HALtheWise/eclectronics-micro-quad/microquad-v1/fab-help.pdf

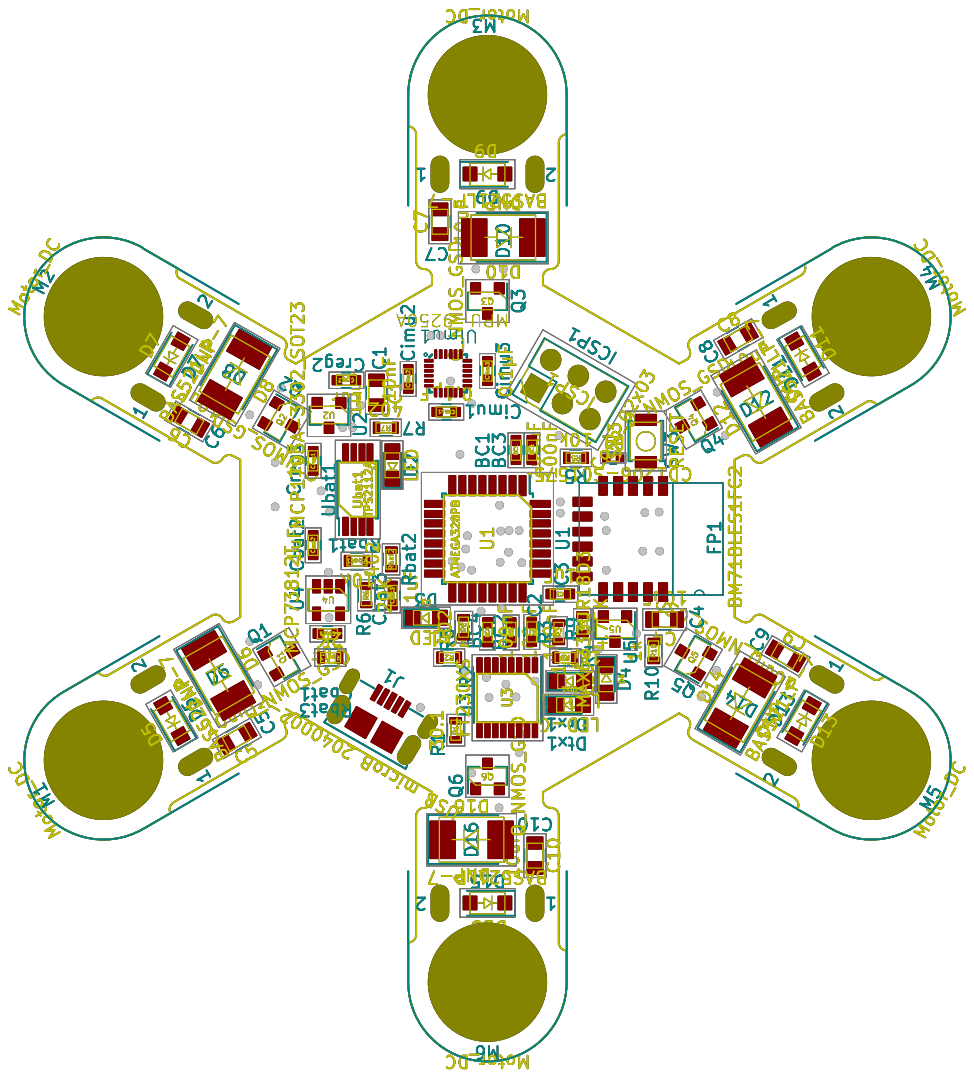
[picture p2: page 1]
