HALtheWise/eclectronics-micro-quad/microquad-v1/microquad-v1.kicad_pcb

## KiCad design microquad-v1/microquad-v1.kicad_pcb (2017-11-17)

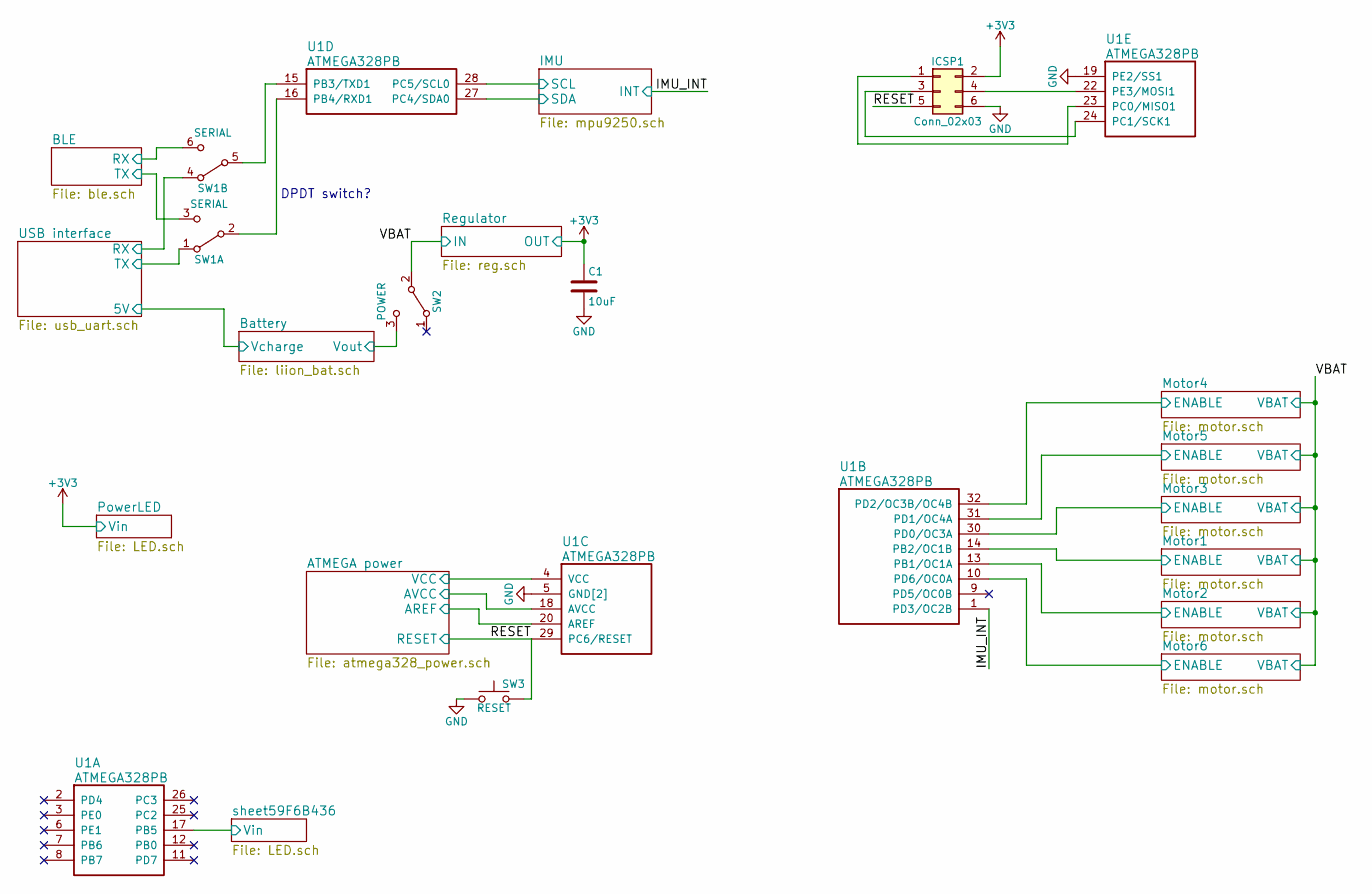
[picture p3: schematic microquad-v1.sch]

Parts:
C1: 10uF; C_0805
ICSP1: Conn_02x03; Pin_Header_Straight_2x03_Pitch2.54mm
SW1: SERIAL; quad_switch
SW2: POWER; quad_switch
SW3: RESET; SW_SPST_B3U-1000P
U1: ATMEGA328PB; TQFP-32_7x7mm_Pitch0.8mm

Connections:
+3V3: C1.1, ICSP1.2, U1.4 (VCC), U1.18 (AVCC), U1.20 (AREF); also elsewhere on the board
/BLE/RX: SW1.6 (C); also elsewhere on the board
/BLE/TX: SW1.3 (C); also elsewhere on the board
/Battery/Vout: SW2.3 (C); also elsewhere on the board
/IMU/SCL: U1.28 (PC5/SCL0); also elsewhere on the board
/IMU/SDA: U1.27 (PC4/SDA0); also elsewhere on the board
/IMU_INT: U1.1 (PD3/OC2B); also elsewhere on the board
/Motor1/ENABLE: U1.14 (PB2/OC1B); also elsewhere on the board
/Motor2/ENABLE: U1.13 (PB1/OC1A); also elsewhere on the board
/Motor3/ENABLE: U1.30 (PD0/OC3A); also elsewhere on the board
/Motor4/ENABLE: U1.32 (PD2/OC3B/OC4B); also elsewhere on the board
/Motor5/ENABLE: U1.31 (PD1/OC4A); also elsewhere on the board
/Motor6/ENABLE: U1.10 (PD6/OC0A); also elsewhere on the board
/RESET: ICSP1.5, SW3.2, U1.29 (PC6/RESET); also elsewhere on the board
/USB interface/RX: SW1.4 (A); also elsewhere on the board
/USB interface/TX: SW1.1 (A); also elsewhere on the board
/VBAT: SW2.2 (B); also elsewhere on the board
/sheet59F6B436/Vin: U1.17 (PB5); also elsewhere on the board
GND: C1.2, ICSP1.6, SW3.1, U1.5 (GND[2]), U1.19 (PE2/SS1), U1.21 (GND[2]); also elsewhere on the board
unnamed: ICSP1.1, U1.23 (PC0/MISO1)
unnamed: ICSP1.3, U1.24 (PC1/SCK1)
unnamed: ICSP1.4, U1.22 (PE3/MOSI1)
unnamed: SW1.2 (B), U1.16 (PB4/RXD1)
unnamed: SW1.5 (B), U1.15 (PB3/TXD1)

Notes on the sheet:
DPDT switch?

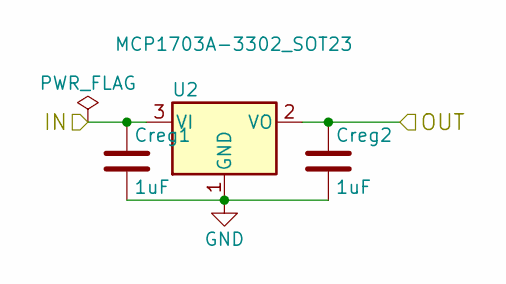
[picture p4: schematic reg.sch]

Parts:
Creg1, Creg2: 1uF; C_0603
U2: MCP1703A-3302_SOT23; SOT-23

Connections:
+3V3: Creg2.1, U2.2 (VO); also elsewhere on the board
/VBAT: Creg1.1, U2.3 (VI); also elsewhere on the board
GND: Creg1.2, Creg2.2, U2.1 (GND); also elsewhere on the board

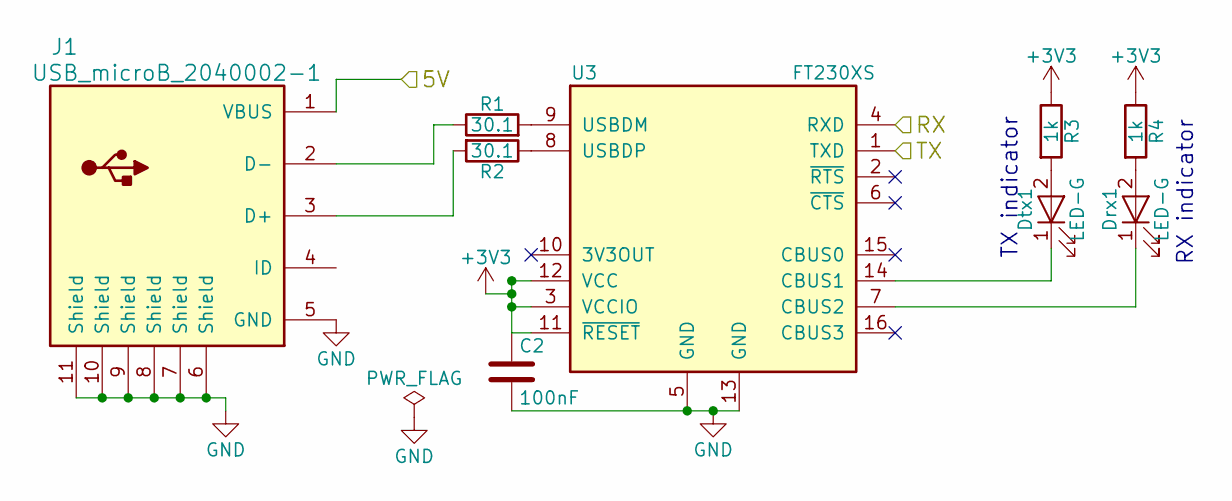
[picture p5: schematic usb_uart.sch]

Parts:
C2: 100nF; C_0603
Drx1: LED-G; LED_0805
Dtx1: LED-G; LED_0805
J1: USB_microB_2040002-1
R1, R2: 30.1; R_0603
R3, R4: 1k; R_0603
U3: FT230XS; SSOP-16_3.9x4.9mm_Pitch0.635mm

Connections:
+3V3: C2.1, R3.1, R4.1, U3.3 (VCCIO), U3.11 (~RESET), U3.12 (VCC); also elsewhere on the board
/USB interface/5V: J1.1 (VBUS); also elsewhere on the board
/USB interface/RX: U3.4 (RXD); also elsewhere on the board
/USB interface/TX: U3.1 (TXD); also elsewhere on the board
GND: C2.2, J1.5 (GND), J1.6 (Shield), J1.7 (Shield), J1.8 (Shield), J1.9 (Shield), J1.10 (Shield), J1.11 (Shield), U3.5 (GND), U3.13 (GND); also elsewhere on the board
unnamed: Drx1.1 (K), U3.7 (CBUS2)
unnamed: Drx1.2 (A), R4.2
unnamed: Dtx1.1 (K), U3.14 (CBUS1)
unnamed: Dtx1.2 (A), R3.2
unnamed: J1.2 (D-), R1.1
unnamed: J1.3 (D+), R2.2
unnamed: R1.2, U3.9 (USBDM)
unnamed: R2.1, U3.8 (USBDP)

Notes on the sheet:
RX indicator
TX indicator

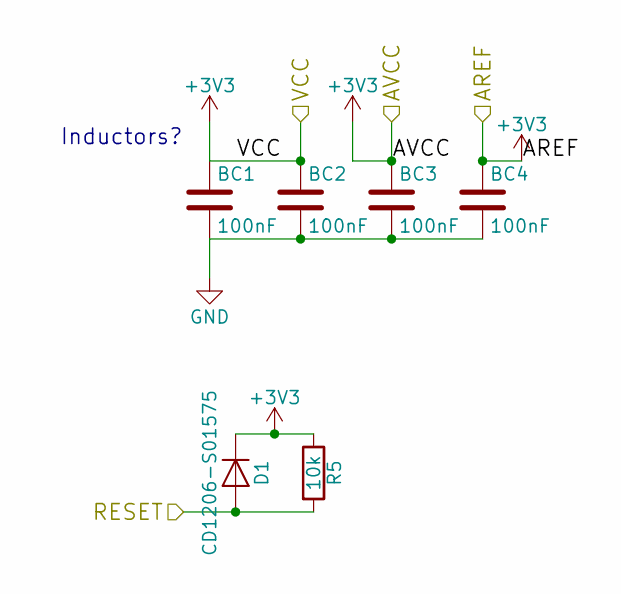
[picture p6: schematic atmega328_power.sch]

Parts:
BC1, BC2, BC3, BC4: 100nF; C_0603
D1: CD1206-S01575; C_0402
R5: 10k; R_0603

Connections:
+3V3: BC1.1, BC2.1, BC3.1, BC4.1, D1.1 (K), R5.1; also elsewhere on the board
/RESET: D1.2 (A), R5.2; also elsewhere on the board
GND: BC1.2, BC2.2, BC3.2, BC4.2; also elsewhere on the board

Notes on the sheet:
Inductors?

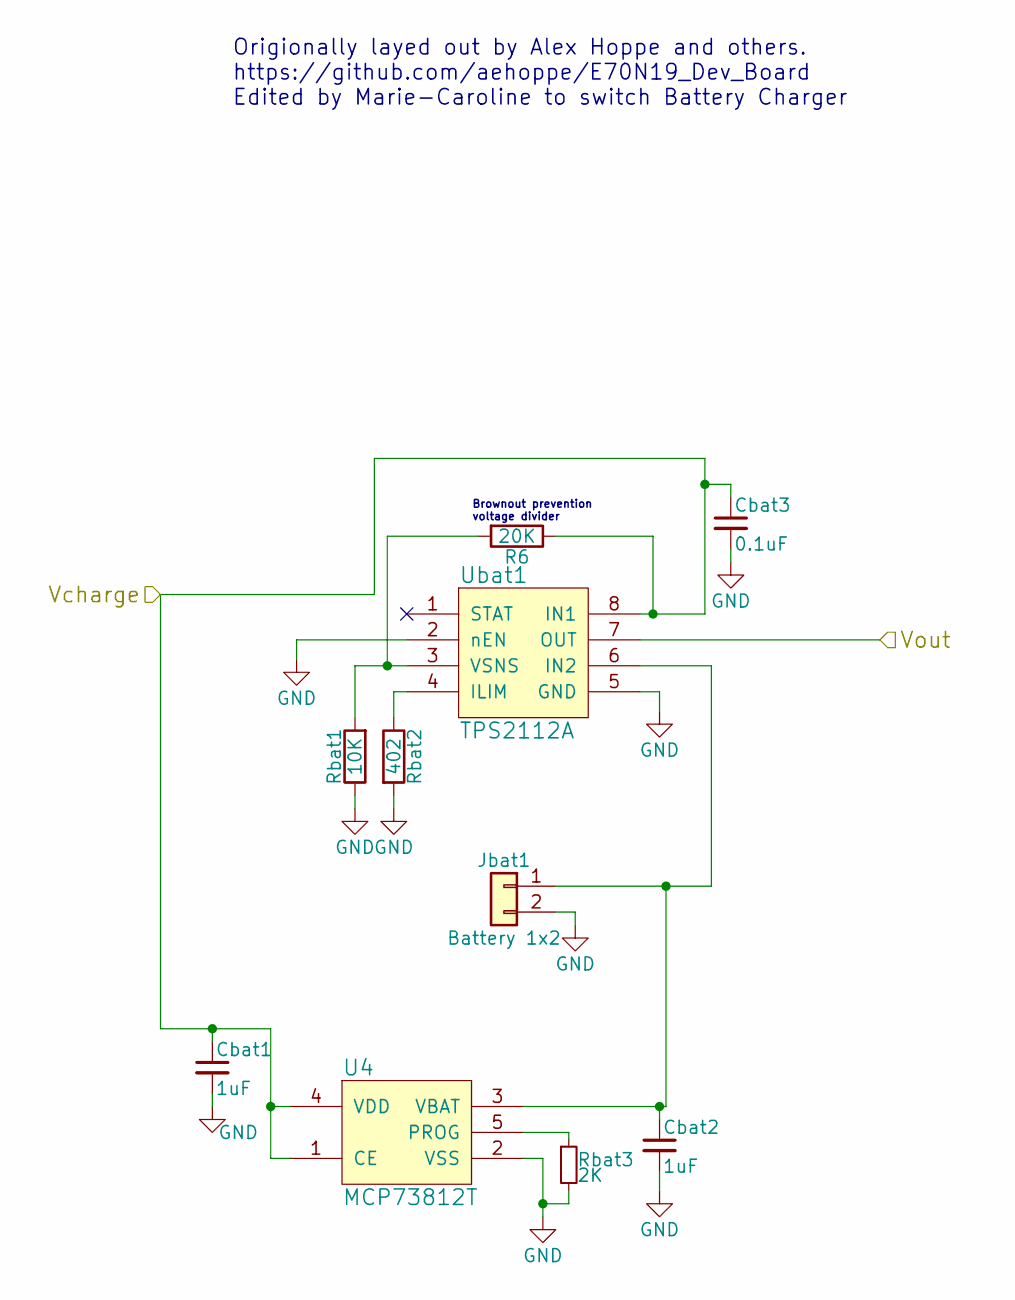
[picture p7: schematic liion_bat.sch]

Parts:
Cbat1, Cbat2: 1uF; C_0603
Cbat3: 0.1uF; C_0603
Jbat1: Battery 1x2; JST_PH_S2B-PH-SM4-TB_02x2.00mm_Angled
R6: 20K; R_0603
Rbat1: 10K; R_0603
Rbat2: 402; R_0603
Rbat3: 2K; R_0603
U4: MCP73812T; SOT-23
Ubat1: TPS2112A; TSSOP-8_4.4x3mm_Pitch0.65mm

Connections:
/Battery/Vout: Ubat1.7 (OUT); also elsewhere on the board
/USB interface/5V: Cbat1.1, Cbat3.1, R6.1, U4.1 (CE), U4.4 (VDD), Ubat1.8 (IN1); also elsewhere on the board
GND: Cbat1.2, Cbat2.2, Cbat3.2, Jbat1.2, Rbat1.1, Rbat2.2, Rbat3.2, U4.2 (VSS), Ubat1.2 (nEN), Ubat1.5 (GND); also elsewhere on the board
unnamed: Cbat2.1, Jbat1.1, U4.3 (VBAT), Ubat1.6 (IN2)
unnamed: R6.2, Rbat1.2, Ubat1.3 (VSNS)
unnamed: Rbat2.1, Ubat1.4 (ILIM)
unnamed: Rbat3.1, U4.5 (PROG)

Notes on the sheet:
Brownout prevention voltage divider
Origionally layed out by Alex Hoppe and others. https://github.com/aehoppe/E70N19_Dev_Board Edited by Marie-Caroline to switch Battery Charger

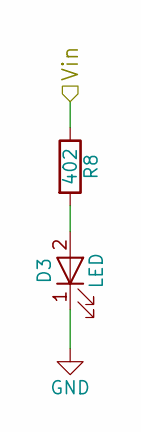
[picture p8: schematic LED.sch]

Parts:
D2: LED; LED_0805
R7: 402; R_0603

Connections:
+3V3: R7.1; also elsewhere on the board
GND: D2.1 (K); also elsewhere on the board
unnamed: D2.2 (A), R7.2

Parts of its further copies:
D3: LED; LED_0805
R8: 402; R_0603

Connections of its further copies:
/sheet59F6B436/Vin: R8.1; also elsewhere on the board
GND: D3.1 (K); also elsewhere on the board
unnamed: D3.2 (A), R8.2

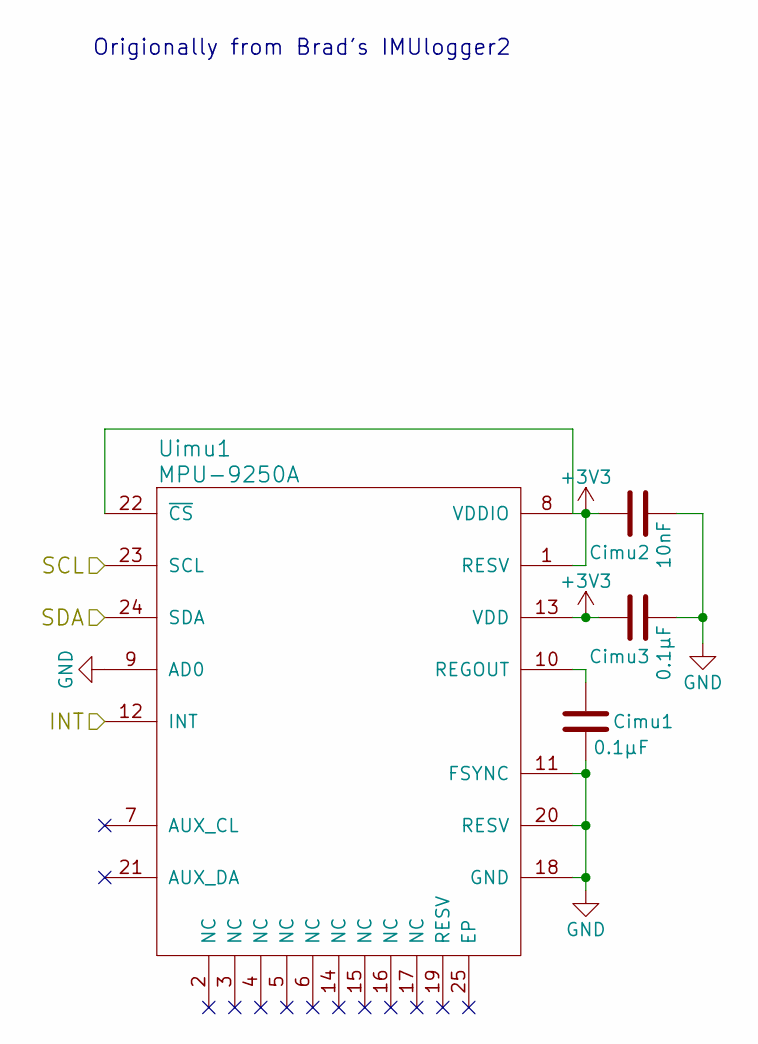
[picture p9: schematic mpu9250.sch]

Parts:
Cimu1, Cimu3: 0.1µF; C_0603
Cimu2: 10nF; C_0603
Uimu1: MPU-9250A; QFN40P300X300X105-25N

Connections:
+3V3: Cimu2.1, Cimu3.1, Uimu1.1 (RESV), Uimu1.8 (VDDIO), Uimu1.13 (VDD), Uimu1.22 (~CS); also elsewhere on the board
/IMU/SCL: Uimu1.23 (SCL); also elsewhere on the board
/IMU/SDA: Uimu1.24 (SDA); also elsewhere on the board
/IMU_INT: Uimu1.12 (INT); also elsewhere on the board
GND: Cimu1.2, Cimu2.2, Cimu3.2, Uimu1.9 (AD0), Uimu1.11 (FSYNC), Uimu1.18 (GND), Uimu1.20 (RESV); also elsewhere on the board
unnamed: Cimu1.1, Uimu1.10 (REGOUT)

Notes on the sheet:
Origionally from Brad's IMUlogger2

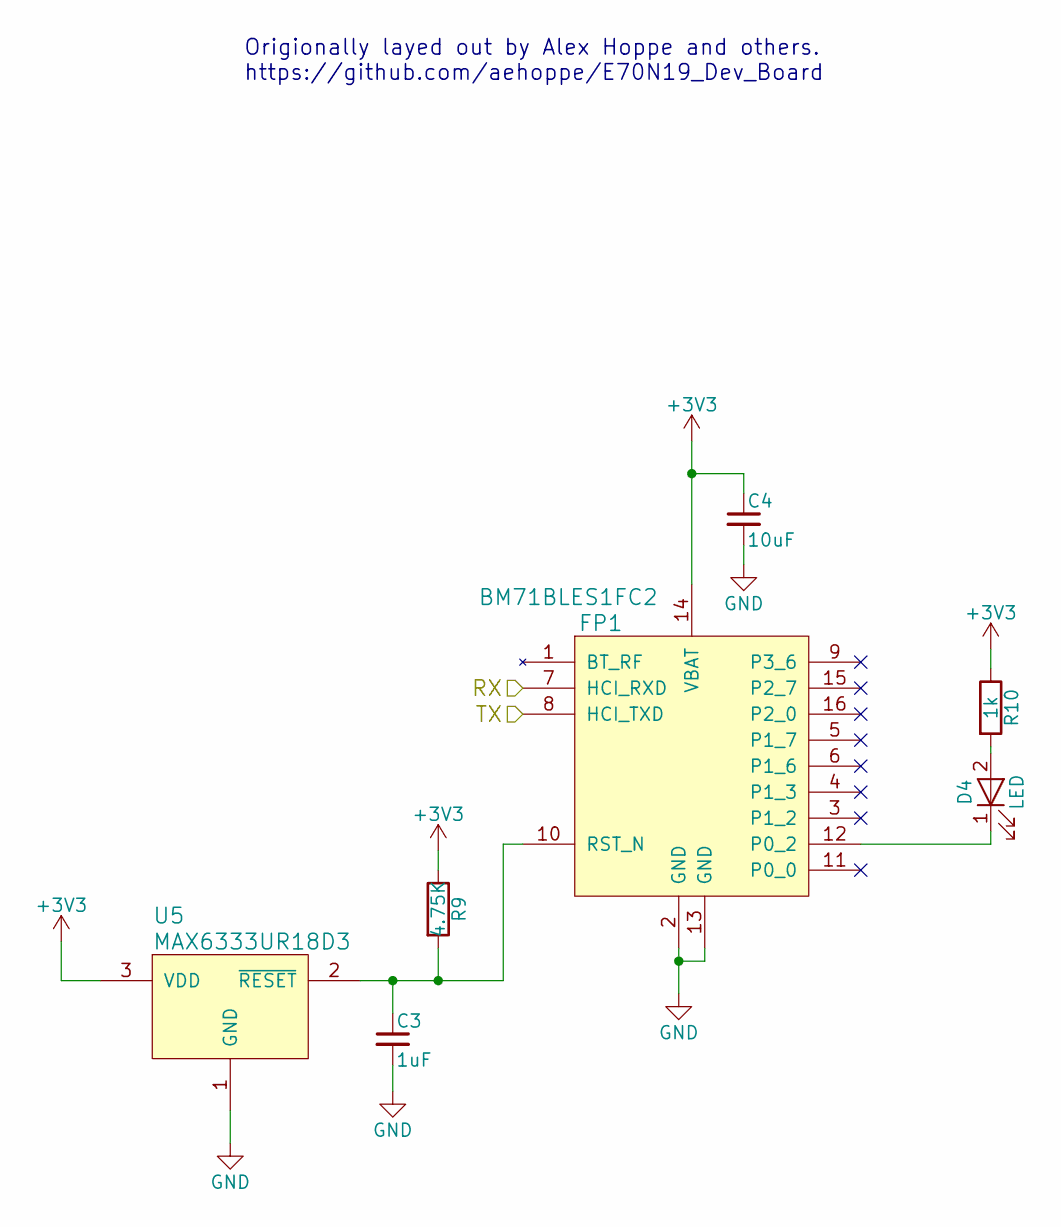
[picture p10: schematic ble.sch]

Parts:
C3: 1uF; C_0603
C4: 10uF; C_0805
D4: LED; LED_0805
FP1: BM71BLES1FC2
R9: 4.75K; R_0603
R10: 1k; R_0603
U5: MAX6333UR18D3; SOT-23

Connections:
+3V3: C4.1, FP1.14 (VBAT), R9.1, R10.1, U5.3 (VDD); also elsewhere on the board
/BLE/RX: FP1.7 (HCI_RXD); also elsewhere on the board
/BLE/TX: FP1.8 (HCI_TXD); also elsewhere on the board
GND: C3.2, C4.2, FP1.2 (GND), FP1.13 (GND), U5.1 (GND); also elsewhere on the board
unnamed: C3.1, FP1.10 (RST_N), R9.2, U5.2 (~RESET)
unnamed: D4.1 (K), FP1.12 (P0_2)
unnamed: D4.2 (A), R10.2

Notes on the sheet:
Origionally layed out by Alex Hoppe and others. https://github.com/aehoppe/E70N19_Dev_Board

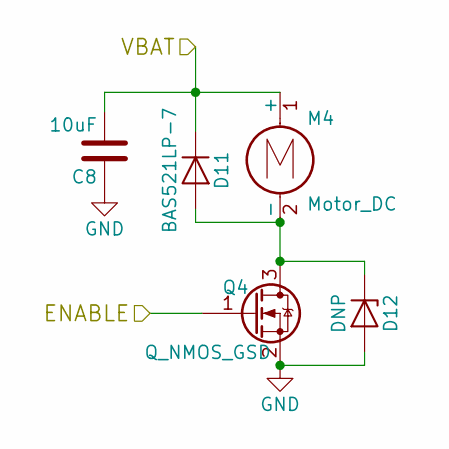
[picture p11: schematic motor.sch]

Parts:
C10: 10uF; C_0805
D5: BAS521LP-7; D_SOD-123F
D6: DNP; D_2114
M6: Motor_DC; quad_motor_v1
Q1: Q_NMOS_GSD; SOT-23

Connections:
/Motor1/ENABLE: Q1.1 (G); also elsewhere on the board
/VBAT: C10.2, D5.1 (K), M6.1 (+); also elsewhere on the board
GND: C10.1, D6.2 (A), Q1.2 (S); also elsewhere on the board

Parts of its further copies:
C5, C6, C7, C8, C9: 10uF; C_0805
D7, D9, D11, D13, D15: BAS521LP-7; D_SOD-123F
D8, D10, D12, D14, D16: DNP; D_2114
M1, M2, M3, M4, M5: Motor_DC; quad_motor_v1
Q2, Q3, Q4, Q5, Q6: Q_NMOS_GSD; SOT-23

Connections of its further copies:
/Motor2/ENABLE: Q2.1 (G); also elsewhere on the board
/Motor3/ENABLE: Q3.1 (G); also elsewhere on the board
/Motor4/ENABLE: Q4.1 (G); also elsewhere on the board
/Motor5/ENABLE: Q5.1 (G); also elsewhere on the board
/Motor6/ENABLE: Q6.1 (G); also elsewhere on the board
/VBAT: C5.2, C6.2, C7.2, C8.2, C9.2, D7.1 (K), D9.1 (K), D11.1 (K), D13.1 (K), D15.1 (K), M1.1 (+), M2.1 (+), M3.1 (+), M4.1 (+), M5.1 (+); also elsewhere on the board
GND: C5.1, C6.1, C7.1, C8.1, C9.1, D8.2 (A), D10.2 (A), D12.2 (A), D14.2 (A), D16.2 (A), Q2.2 (S), Q3.2 (S), Q4.2 (S), Q5.2 (S), Q6.2 (S); also elsewhere on the board
unnamed: D7.2 (A), D8.1 (K), M2.2 (-), Q2.3 (D)
unnamed: D9.2 (A), D10.1 (K), M3.2 (-), Q3.3 (D)
unnamed: D11.2 (A), D12.1 (K), M4.2 (-), Q4.3 (D)
unnamed: D13.2 (A), D14.1 (K), M5.2 (-), Q5.3 (D)

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
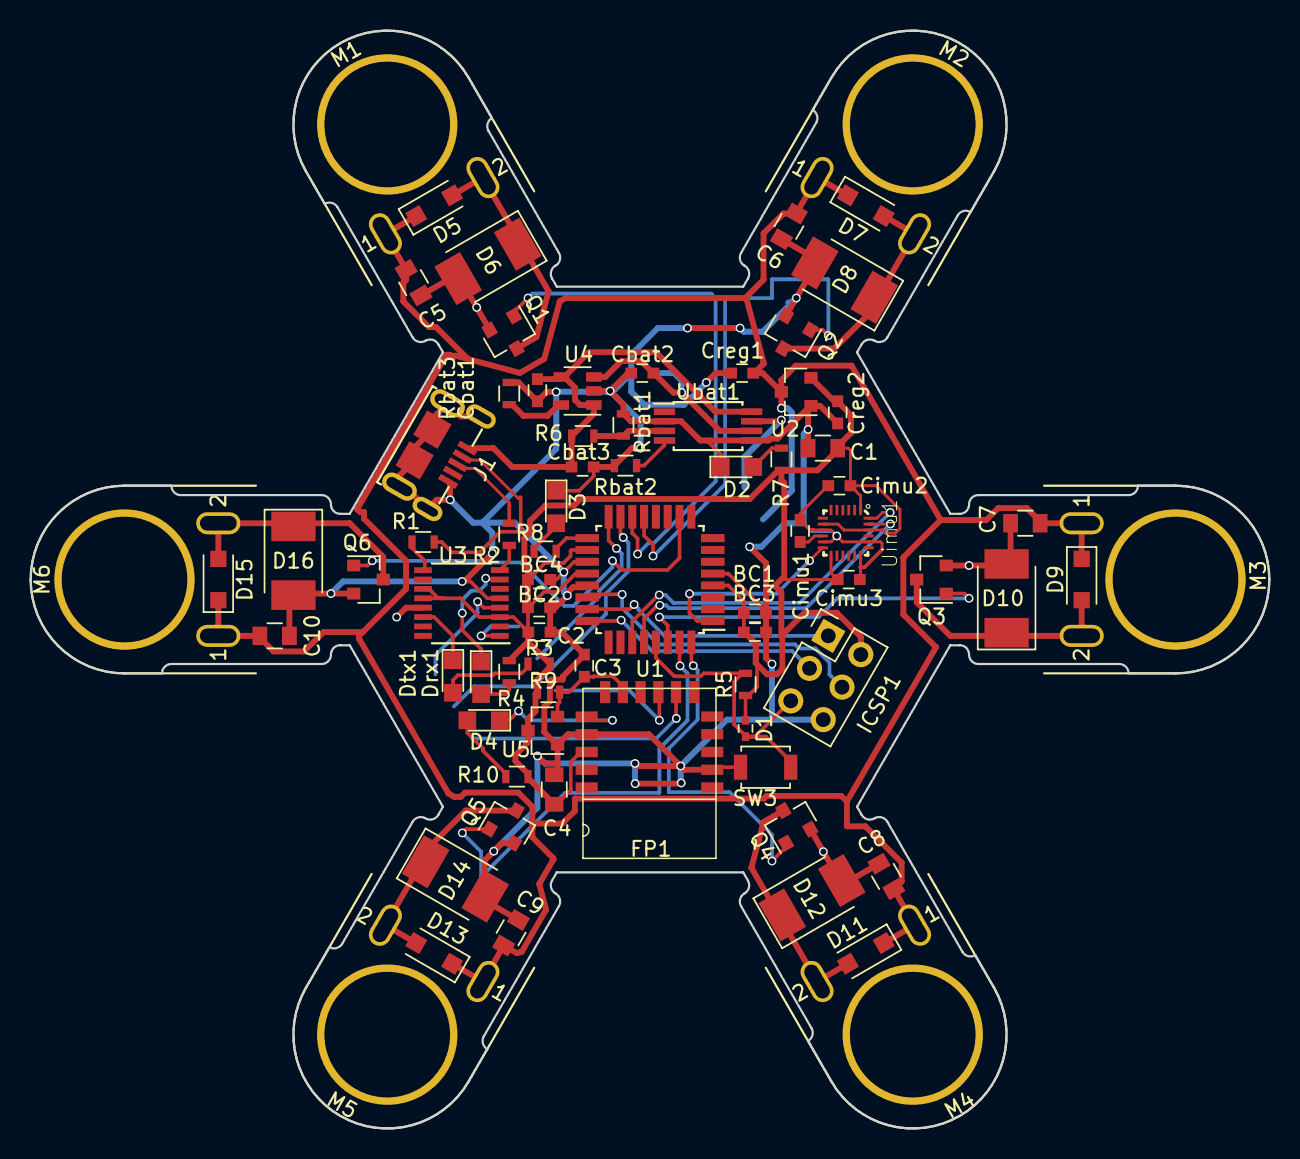
[picture p12: board microquad-v1.kicad_pcb from above]

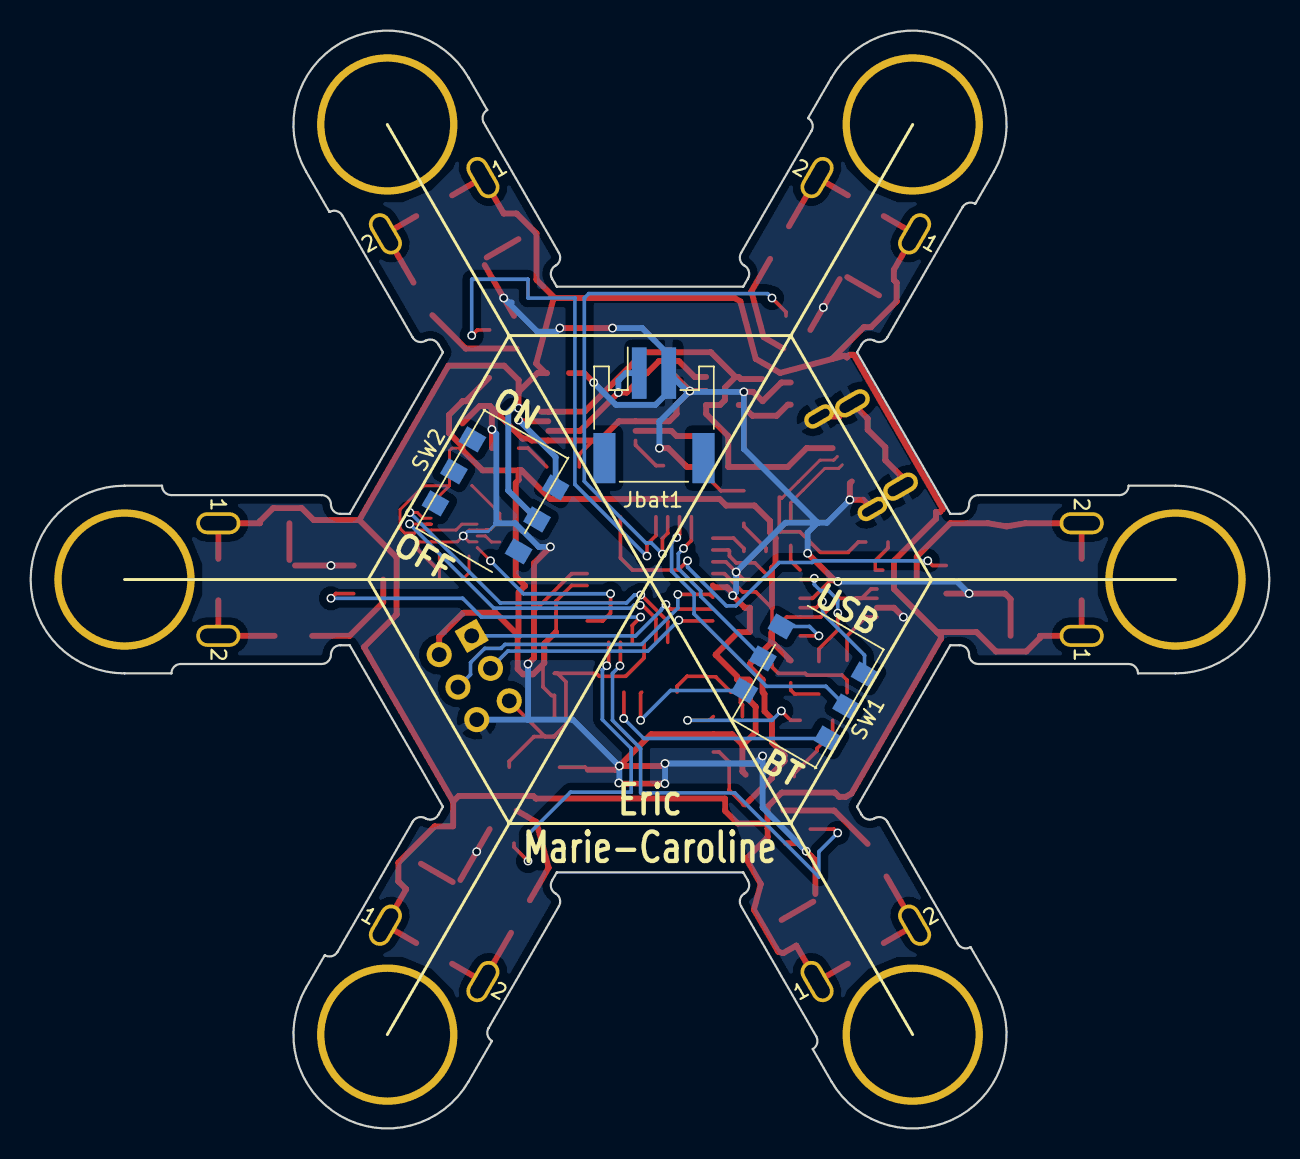
[picture p13: board microquad-v1.kicad_pcb from below]

Board: 2 copper layers, 83.8 x 74.3 mm, 79 parts (3 on the bottom side), 49 nets.
