HALtheWise/eclectronics-micro-quad/(commit log)

2017-10-26 Added gitignore and template project
    [microquad-v1.kicad_pcb, microquad-v1.sch]
2017-10-26 Added 3V3 regulator and USB UART schematics from Eric's Project 2
    [microquad-v1.sch, reg.sch, usb_uart.sch]
2017-10-26 More libraries
    [atmega328_power.sch, microquad-v1.sch, reg.sch, usb_uart.sch]
2017-10-26 Added first version of kipart
    [atmega328_power.sch, microquad-v1.sch, reg.sch, usb_uart.sch]
2017-10-28 Added Hoppe's battery circuit
    [atmega328_power.sch, liion_bat.sch, microquad-v1.sch, reg.sch, usb_uart.sch]
2017-10-28 Labeled Battery
    [microquad-v1.sch]
2017-10-29 Added MPU9250 from Brad's Imulogger
    [atmega328_power.sch, liion_bat.sch, microquad-v1.sch, mpu9250.sch, reg.sch, usb_uart.sch]
2017-10-29 Brought in BLE module from Hoppe's project
    [atmega328_power.sch, ble.sch, liion_bat.sch, microquad-v1.sch, mpu9250.sch, reg.sch, usb_uart.sch]
2017-10-29 Add power switch
    [microquad-v1.sch]
2017-10-29 Joe fixed merge
    [microquad-v1.sch]
2017-10-29 Double checked and hooked up connections for BLE Added Power and Pin 12 LED
    [LED.sch, atmega328_power.sch, ble.sch, liion_bat.sch, microquad-v1.sch, mpu9250.sch, reg.sch, usb_uart.sch]
2017-10-29 Changed IMU to I2C pins
    [liion_bat.sch, mpu9250.sch, usb_uart.sch]
2017-10-29 Fixed imported IMU sheet
    [microquad-v1.sch]
2017-10-29 Add new battery sub-schematic with new battery charger MCP73812
    [LED.sch, atmega328_power.sch, ble.sch, microquad-v1.sch, mpu9250.sch, newliion_bat.sch, reg.sch, usb_uart.sch]
2017-10-29 Added motors
    [microquad-v1.sch]
2017-10-29 Wired in motors
    [atmega328_power.sch, ble.sch, microquad-v1.sch, mpu9250.sch, newliion_bat.sch, reg.sch, usb_uart.sch]
2017-10-29 Switched battery and merged some more stuff
    [atmega328_power.sch, ble.sch, liion_bat.sch, microquad-v1.sch, mpu9250.sch, newliion_bat.sch, reg.sch, usb_uart.sch]
2017-10-30 Add switch, LEDs, and no connector marks (probably still missing some, I'm not sure what all you still need
    [LED.sch, atmega328_power.sch, ble.sch, microquad-v1.sch, mpu9250.sch, reg.sch, usb_uart.sch]
2017-10-30 Wired in IMU
    [microquad-v1.sch]
2017-10-30 Moved LED to pin PB5
    [LED.sch, atmega328_power.sch, ble.sch, liion_bat.sch, microquad-v1.sch, mpu9250.sch, reg.sch, usb_uart.sch]
2017-10-30 Changed LED resistor values
    [LED.sch, ble.sch, usb_uart.sch]
2017-10-30 Added reset button
    [LED.sch, atmega328_power.sch, liion_bat.sch, microquad-v1.sch]
2017-10-30 Added IMU interrupt
    [microquad-v1.sch]
2017-10-30 Changed switches to SPDT to prevent erroneous assignment
    [microquad-v1.sch]
2017-10-30 Aesthetic rearrangement
    [LED.sch, atmega328_power.sch, liion_bat.sch, microquad-v1.sch, mpu9250.sch, reg.sch, usb_uart.sch]
2017-10-30 Fixed DRC errors (the ladybug is now happy)
    [LED.sch, atmega328_power.sch, ble.sch, liion_bat.sch, microquad-v1.sch, mpu9250.sch, reg.sch, usb_uart.sch]
2017-10-30 Notes from schematic review
    [LED.sch, atmega328_power.sch, ble.sch, liion_bat.sch, microquad-v1.sch, mpu9250.sch, usb_uart.sch]
2017-10-30 Changed to DPDT switches
    [LED.sch, atmega328_power.sch, ble.sch, liion_bat.sch, microquad-v1.sch, mpu9250.sch, reg.sch, usb_uart.sch]
2017-10-30 Added bypass diodes and extracted motors into separate schematic
    [LED.sch, atmega328_power.sch, ble.sch, liion_bat.sch, microquad-v1.sch, motor.sch, mpu9250.sch, reg.sch]
2017-10-31 Added layout for transistor
    [LED.sch, atmega328_power.sch, ble.sch, liion_bat.sch, microquad-v1.sch, motor.sch, mpu9250.sch, reg.sch]
2017-10-31 Added footprint library for USB connector and BT chip
    [motor.sch, usb_uart.sch]
2017-10-31 Added v1 layout for motor
2017-11-01 Finished footprint work 10/31
    [liion_bat.sch, microquad-v1.sch, motor.sch]
2017-11-03 Finished in-class work 10/2
    [LED.sch, ble.sch, motor.sch, usb_uart.sch]
2017-11-03 Finished footprints for diodes
    [LED.sch, atmega328_power.sch, ble.sch, liion_bat.sch, motor.sch, mpu9250.sch, usb_uart.sch]
2017-11-03 Started layout
    [_saved_liion_bat.sch, microquad-v1.kicad_pcb, motor.sch]
2017-11-03 All non-motor components placed on board
    [microquad-v1.kicad_pcb]
2017-11-03 Initial power routing to all major chips
    [LED.sch, _saved_liion_bat.sch, atmega328_power.sch, microquad-v1.kicad_pcb, motor.sch]
2017-11-03 Handled some wire routing for IMU
    [microquad-v1.kicad_pcb]
2017-11-03 Finished routing most of the top side
    [microquad-v1.kicad_pcb]
2017-11-03 Added ground pour
    [microquad-v1.kicad_pcb]
2017-11-04 Made a pretty array of motors
    [microquad-v1.kicad_pcb]
2017-11-04 Fixed motor component labels and reimported netlist
    [microquad-v1.kicad_pcb]
2017-11-04 Started compacting components
    [microquad-v1.kicad_pcb]
2017-11-04 Change motor component references
    [microquad-v1.kicad_pcb]
2017-11-04 Additional compaction
    [microquad-v1.kicad_pcb]
2017-11-05 Finished placing components more tightly
    [microquad-v1.kicad_pcb]
2017-11-05 Merged new netlist
    [microquad-v1.kicad_pcb]
2017-11-06 Add tracks on arms and connect VBAT, requires DRC violations... (not actual violations, KiCad just thinks they are)
    [microquad-v1.kicad_pcb]
2017-11-06 Fixed VBAT connections
    [microquad-v1.kicad_pcb, microquad-v1.sch, motor.sch]
2017-11-06 Fixed disconnects around the board
    [microquad-v1.kicad_pcb]
2017-11-06 Ladybug is satisfied
    [microquad-v1.kicad_pcb, microquad-v1.sch, motor.sch]
2017-11-06 Better bridges
    [microquad-v1.kicad_pcb]
2017-11-06 Changed visibility of layers
    [microquad-v1.kicad_pcb]
2017-11-06 Silkscreen work on front
    [microquad-v1.kicad_pcb]
2017-11-06 Add outer silkscreen
    [microquad-v1.kicad_pcb]
2017-11-06 Rerouted vbat and moved USB
    [microquad-v1.kicad_pcb]
2017-11-06 Ready to submit
    [microquad-v1.kicad_pcb]
2017-11-08 Removed copper pour from underneath bluetooth module
    [microquad-v1.kicad_pcb]
2017-11-17 Printed fabrication drawing
    [microquad-v1.kicad_pcb]
